jaxxtech/VectorNetworkAnalyser/README.md

View this project on [CADLAB.io](https://cadlab.io/project/1782). 

# VectorNetworkAnalyser
