jaxxtech/VectorNetworkAnalyser/VNA/vna/vna-partslist.xlsx

Id | Designator | Item | Quantity | Designation/value | rs stock no | unit cost | total | min qty | notes | ordering
1 | J9 | 15 pin 2.54mm pin header socket | 1 | vin_d13 |  |  | 0 |  |  | fset store
2 | J8 | 15 pin 2.54mm pin header socket | 1 | tx_d12 |  |  | 0 |  |  | fset store
3 | Y1 | QANTEK 16MHz Crystal ±20ppm HC-49/U-S 2-Pin, in pack of 10 | 1 | 16MHz | 814-9440 | 0.35 | 0.35 | 10 |  | rs components, or similar
4 | X1 | Clock Oscillator 5H14ET-30.000, 30 MHz, ±50ppm HCMOS, TTL 15pF, 14-Pin PDIP, 20.2 x 10.7 x 5.08mm | 1 | 30MHz | 767-5285 | 2.32 | 2.32 | 1 |  | rs components, or similar
5 | U9,U3,U2 | HMC284 RF Switch IC | 3 | HMC284 | 862-6310 | 4.195 | 12.585 | 2 |  | from rs components
6 | U8 | Microchip Technology ATMEGA328P-AU, 8bit AVR Microcontroller, 20MHz, 32 kB Flash, 32-Pin TQFP | 1 | ATmega328PB-AU | 131-0271 | 3.41 | 3.41 | 2 |  | fset store or rs components
7 | U7 | FTDI Chip FT232RL USB to Serial UART 3MBd, 28-Pin, SSOP | 1 | FT232RL | 406-580 | 8.03 | 8.03 | 1 |  | fset store or rs components
8 | U6 | Texas Instruments LM1117MP-5.0/NOPB, LDO Regulator, 800mA, 5 V, ±1% 3+Tab-Pin, SOT-223 | 1 | LM1117-5.0 | 533-9583 | 1.56 | 1.56 | 1 |  | from fset store
9 | U5 | AD8302ARUZ Analog Devices, RF Amplifier Gain and Phase Detector 2-Channel, 14-Pin TSSOP | 1 | AD8302ARUZ | 697-7262 | 34.86 | 34.86 | 1 |  | from rs components
10 | U4 | AD9851BRSZ, Direct Digital Synthesizer 10 bit-Bit 180000ksps, 28-Pin SSOP | 1 | AD9851 | 413-011 | 40.54 | 40.54 | 1 |  | from rs components
11 | U1 | NXP 74HCT04D,652, Hex Inverter, 4.5 ? 5.5 V, 14-Pin SOIC | 1 | 74HCT04 | 112-9988 | 0.51 | 0.51 | 1 |  | fset store or rs components
12 | SW1 | Surface mount SPDT push button Switch, normally open | 1 | Reset | 718-2477 | 0.4 | 0.4 | 5 |  | rs components or fset store
13 | R23,R20,R16,R15,R14,R13,R12,R11,R10,R9 | surface mount resistor | 10 | 1k |  |  |  |  |  | fset store
14 | R22 | surface mount resistor | 1 | 3.9k |  |  |  |  |  | fset store
15 | R21 | surface mount resistor | 1 | 25 |  |  |  |  |  | fset store
16 | R19,R18,R6,R5,R4,R3,R2,R1 | surface mount resistor | 8 | 50 |  |  |  |  |  | fset store
17 | R17 | surface mount resistor | 1 | 2k |  |  |  |  |  | fset store
18 | R8,R7 | surface mount resistor | 2 | 47 |  |  |  |  |  | fset store
19 | J7 | 6 pin 2.54mm pin header socket | 1 | Bluetooth Module Socket | 267-7400 | 1.022 | 1.022 | 5 | comes in runs of 20 pins | fset store
20 | J6 | 3 PinHeader_1x03_P2.54mm_Vertical | 1 | ICSP 2,4,6 | 547-3166 | 1.41 | 1.41 | 1 | run of 36 pins | fset store
21 | J5 | 3 PinHeader_1x03_P2.54mm_Vertical | 1 | ICSP 1,3,5 |  |  | 0 |  |  | fset store
22 | J4 | TE Connectivity Right Angle 50? PCB Mount BNC Connector, jack, Nickel, Through Hole Termination | 1 | Pt2 | 616-3090 | 3.75 | 3.75 | 1 |  | rs components
23 | J3 | TE Connectivity Right Angle 50? PCB Mount BNC Connector, jack, Nickel, Through Hole Termination | 1 | Pt1 | 616-3090 | 3.75 | 3.75 | 1 |  | rs components
24 | J2 | DC barrel jack, pcb mount | 1 | DC_IN_Conn | 122-4879 | 1.75 | 1.75 | 5 |  | rs components
25 | J1 | Amphenol FCI, Right Angle SMT, Type B Version 2.0 Micro USB Connector Receptacle | 1 | USB_B_Micro | 714-2347 | 1.05 | 1.05 | 5 |  | rs components
26 | HY2,HY1 | Directional_Coupler | 2 | Directional_Coupler | n/a | 0 | 0 | 0 | hand built | n/a
27 | D5 | SMD Chip LED - red | 1 | TX_LED |  |  | 0 |  |  | fset store
28 | D4 | SMD Chip LED - blue | 1 | onboard led |  |  | 0 |  |  | fset store
29 | D3 | SMD Chip LED - green | 1 | RX_LED |  |  | 0 |  |  | fset store
30 | D2 | SMD Chip LED - red | 1 | POWER_LED |  |  | 0 |  |  | fset store
31 | D1 | 40V schottky 350mA, Diode, 2-Pin SOD-323 | 1 | S4 |  |  | 0 |  |  | fset store or rs components
32 | C35,C34,C33,C32,C30 | Surface mount Capacitor | 5 | 0.1u |  |  | 0 |  |  | fset store
33 | C31 | Surface mount Capacitor | 1 | 10u |  |  | 0 |  |  | fset store
34 | C29 | Surface mount Capacitor | 1 | 330p |  |  | 0 |  |  | fset store
35 | C28 | Surface mount Capacitor | 1 | 330u |  |  | 0 |  |  | fset store
36 | C27,C26 | Surface mount Capacitor - timing circuit must be C0G | 2 | C0G 22p |  |  | 0 |  |  | fset store
37 | C25,C24,C23,C22,C21,C17,C6,C5,C4,C3,C2,C1 | Surface mount Capacitor | 12 | 100n |  |  | 0 |  |  | fset store
38 | C20,C18,C15 | Surface mount Capacitor | 3 | 1u |  |  | 0 |  |  | fset store
39 | C19,C16 | Surface mount Capacitor | 2 | 4.7u |  |  | 0 |  |  | fset store
40 | C14,C12 |  | 2 | DNP |  |  | 0 |  |  | n/a
41 | C13,C11,C10,C9,C8,C7 | Surface mount Capacitor | 6 | 1n |  |  | 0 |  |  | fset store
 |  |  |  |  |  | total cost | 117.297
