jaxxtech/VectorNetworkAnalyser/VNA/vna/vna.kicad_pcb

## KiCad design VNA/vna/vna.kicad_pcb (2019-10-09)

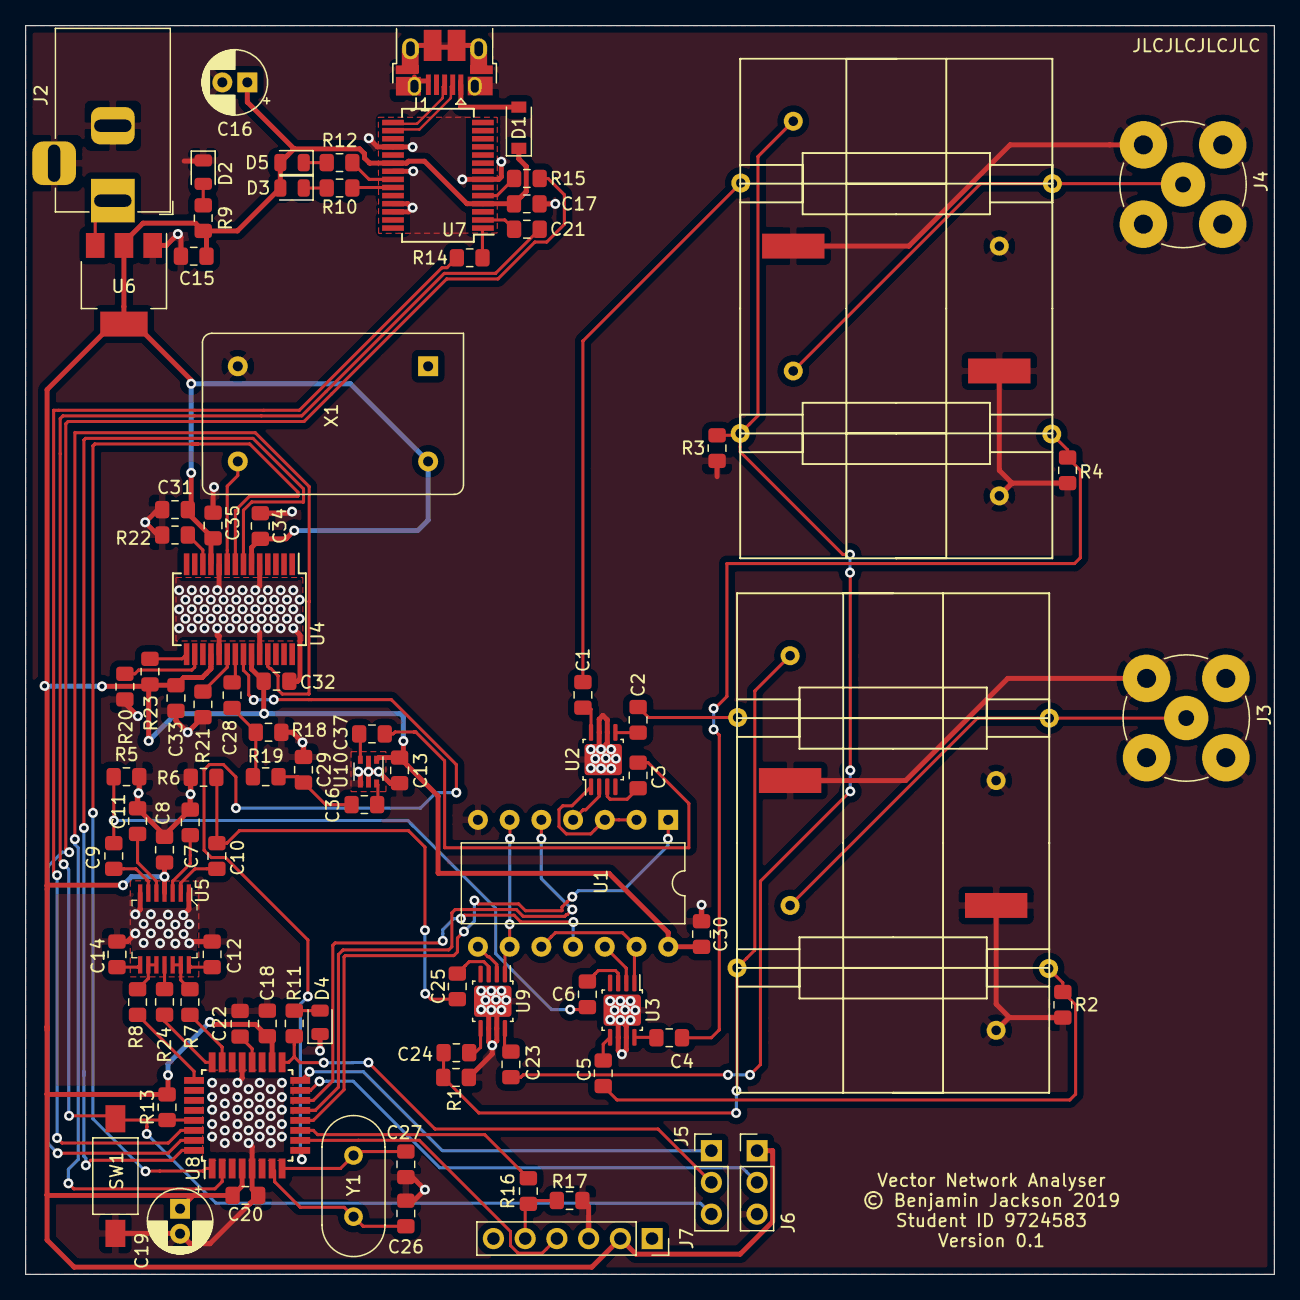
[picture p1: board vna.kicad_pcb from above]

Board: 2 copper layers, 100.0 x 100.0 mm, 88 parts (0 on the bottom side), 82 nets.

Parts:
C1, C2, C3, C4, C5, C6, C17, C21, C22, C23, C24, C25, C28: 100n; C_0805_2012Metric_Pad1.15x1.40mm_HandSolder
C7, C8, C9, C10, C11, C29: 1n; C_0805_2012Metric_Pad1.15x1.40mm_HandSolder
C12, C14: DNP; C_0805_2012Metric_Pad1.15x1.40mm_HandSolder
C13, C36, C37: 470p; C_0805_2012Metric_Pad1.15x1.40mm_HandSolder
C15, C18, C20: 1u; C_0805_2012Metric_Pad1.15x1.40mm_HandSolder
C16, C19: 4.7u; CP_Radial_D5.0mm_P2.00mm
C26, C27: C0G 22p; C_0805_2012Metric_Pad1.15x1.40mm_HandSolder
C30, C32, C33, C34, C35: 0.1u; C_0805_2012Metric_Pad1.15x1.40mm_HandSolder
C31: 10u; C_0805_2012Metric_Pad1.15x1.40mm_HandSolder
D1: S4; D_SOD-123
D2: POWER_LED; LED_0805_2012Metric
D3: RX_LED; LED_0805_2012Metric
D4: onboard led; LED_0805_2012Metric
D5: TX_LED; LED_0805_2012Metric
HY1, HY2: Directional_Coupler
J1: USB_B_Micro; USB_Micro-B_Amphenol_10103594-0001LF_Horizontal
J2: DC_IN_Conn; BarrelJack_Horizontal
J3: Pt1; BNC_TEConnectivity_1478204_Vertical
J4: Pt2; BNC_TEConnectivity_1478204_Vertical
J5: ICSP 1,3,5; PinHeader_1x03_P2.54mm_Vertical
J6: ICSP 2,4,6; PinHeader_1x03_P2.54mm_Vertical
J7: Bluetooth Module Socket; PinSocket_1x06_P2.54mm_Vertical
R1, R2: 50 DNP; R_0805_2012Metric_Pad1.15x1.40mm_HandSolder
R3, R4: 50_DNP; R_0805_2012Metric_Pad1.15x1.40mm_HandSolder
R5, R6: 50; R_0805_2012Metric_Pad1.15x1.40mm_HandSolder
R7, R8, R24: 47; R_0805_2012Metric_Pad1.15x1.40mm_HandSolder
R9, R10, R11, R12, R13, R14, R15, R16, R20, R23: 1k; R_0805_2012Metric_Pad1.15x1.40mm_HandSolder
R17: 2k; R_0805_2012Metric_Pad1.15x1.40mm_HandSolder
R18: 16k; R_0805_2012Metric_Pad1.15x1.40mm_HandSolder
R19: 100m; R_0805_2012Metric_Pad1.15x1.40mm_HandSolder
R21: 25; R_0805_2012Metric_Pad1.15x1.40mm_HandSolder
R22: 3.9k; R_0805_2012Metric_Pad1.15x1.40mm_HandSolder
SW1: Reset; SW_SPST_FSMSM
U1: 74HCT04; DIP-14_W10.16mm
U2, U3, U9: HMC284; MSOP-8-1EP_3x3mm_P0.65mm_EP2.5x3mm_Mask1.73x2.36mm
U4: AD9851; SSOP-28_5.3x10.2mm_P0.65mm
U5: AD8302ARUZ; TSSOP-14_W4.4mm
U6: LM1117-5.0; SOT-223-3_TabPin2
U7: FT232RL; SSOP-28_5.3x10.2mm_P0.65mm
U8: ATmega328PB-AU; TQFP-32_7x7mm_P0.8mm
U10: BGA2851; SOT-363_SC-70-6
X1: 30MHz; Oscillator_DIP-14
Y1: 16MHz; Crystal_HC18-U_Vertical

Connections:
+5V: C8.2, C13.1, C15.1, C16.1, C17.1, C18.1, C19.1, C20.1, C30.1, C31.1, C32.1, C33.1, C34.1, C35.1, D1.1, D3.2, D5.2, J6.1, J7.2, R9.1, R13.1, R23.2, U1.14, U4.6, U4.11, U4.18, U4.23, U5.4, U6.2, U7.4, U7.20, U8.4, U8.18, U10.1, X1.14
/ACtrl: U1.5, U8.13
/Aref: C22.1, U8.20
/BCtrl: U1.11, U8.14
/ControlSystem.sch/AIN1_D7: R16.2, U8.11
/ControlSystem.sch/OC0A_AIN0_D6: J7.4, U8.10
/ControlSystem.sch/OC3A_RXD_D0: R14.2, U8.30
/ControlSystem.sch/OC4A_TXD_D1: R15.1, U8.31
/ControlSystem.sch/RESET: C21.1, J5.3, R13.2, SW1.1, U8.29
/ControlSystem.sch/RX: R14.1, U7.1
/ControlSystem.sch/RXD1_MISO_D12: J5.1, U8.16
/ControlSystem.sch/SCK_D13: J5.2, R11.1, U8.17
/ControlSystem.sch/TX: R15.2, U7.5
/ControlSystem.sch/TXD1_MOSI_OC2_D11: J6.2, U8.15
/D+: J1.3, U7.15
/D-: J1.2, U7.16
/DATA: U4.25, U8.2
/FQ_UD: U4.8, U8.1
/Fmeasured: C6.2, C9.2, R5.2
/Freference: C10.2, C25.2, R6.1
/Fwd_50ohm_A: C24.1, HY1.4, HY1.7, R1.1
/Fwd_50ohm_B: C23.1, HY2.4, HY2.7, R3.1
/PowerManagement/USB5V: D1.2, J1.1
/RF_RESET: U4.22, U8.9
/Receiver.sch/OffsetA: C7.1, U5.3
/Receiver.sch/VMag: R7.1, U8.23
/Receiver.sch/VPhase: R8.1, U8.25
/Receiver.sch/VRef(1v7): R24.1, U8.24
/Rev_50ohm_A: C5.1, HY1.6, R2.1
/Rev_50ohm_B: C4.1, HY2.6, R4.1
/SRC_50ohm: C3.2, C37.1
/SrcCtrl: U1.1, U8.12
/Src_50ohm_A: C2.1, HY1.1
/Src_50ohm_B: C1.1, HY2.1
/W_CLK: U4.7, U8.32
/pt1_50ohm: HY1.2, HY1.10, J3.1
/pt2_50ohm: HY2.2, HY2.10, J4.1
GND: C7.2, C8.1, C11.1, C12.1, C13.2, C14.2, C15.2, C16.2, C17.2, C18.2, C19.2, C20.2, C22.2, C26.1, C27.1, C29.2, C30.2, C31.2, C32.2, C33.2, C34.2, C35.2, D2.1, D4.1, HY1.3, HY1.5, HY1.8, HY1.9, HY2.3, HY2.5, HY2.8, HY2.9, J1.5, J1.6, J2.2, J2.3, J3.2, J4.2, J6.3, J7.3, R1.2, R2.2, R3.2, R4.2, R5.1, R6.2, R17.1, R18.2, R20.1, R21.1, R22.1, SW1.2, U1.7, U2.6, U2.7, U2.9, U3.6, U3.7, U3.9, U4.5, U4.10, U4.19, U4.24, U5.1, U5.7, U6.1, U7.7, U7.18, U7.21, U7.25, U7.26, U8.5, U8.21, U9.6, U9.7, U9.9, U10.2, U10.4, U10.5, X1.7
unnamed: C1.2, U2.8
unnamed: C2.2, U2.5
unnamed: C3.1, U2.3
unnamed: C4.2, U3.8
unnamed: C5.2, U3.5
unnamed: C6.1, U3.3
unnamed: C9.1, U5.6
unnamed: C10.1, U5.2
unnamed: C11.2, U5.5
unnamed: C12.2, U5.14
unnamed: C14.1, U5.8
unnamed: C21.2, U7.2
unnamed: C23.2, U9.8
unnamed: C24.2, U9.5
unnamed: C25.1, U9.3
unnamed: C26.2, U8.7, Y1.1
unnamed: C27.2, U8.8, Y1.2
unnamed: C28.1, R18.1, R19.1
unnamed: C28.2, U4.21
unnamed: C29.1, C36.2, R19.2
unnamed: C36.1, U10.6
unnamed: C37.2, U10.3
unnamed: D2.2, R9.2
unnamed: D3.1, R10.1
unnamed: D4.2, R11.2
unnamed: D5.1, R12.1
unnamed: J7.5, R16.1, R17.2
unnamed: R7.2, U5.12, U5.13
unnamed: R8.2, U5.9, U5.10
unnamed: R10.2, U7.23
unnamed: R12.2, U7.22
unnamed: R20.2, U4.16
unnamed: R21.2, U4.20
unnamed: R22.2, U4.12
unnamed: R23.1, U4.15
unnamed: R24.2, U5.11
unnamed: U1.2, U1.3, U2.1
unnamed: U1.4, U2.2
unnamed: U1.6, U1.9, U9.1
unnamed: U1.8, U9.2
unnamed: U1.10, U1.13, U3.1
unnamed: U1.12, U3.2
unnamed: U4.9, X1.8
VDC: J2.1, U6.3
