jaxxtech/VectorNetworkAnalyser/(commit log)

2019-05-17 initial commit
    initial commit in order to test cadlab.io
    [ControlSystem.sch, Directional-Coupler.sch, DirectionalCoupler1.sch, DirectionalCoupler2.sch, RFSwitchFWD.sch, RFSwitchREV.sch, RFSwitchSource.sch, Receiver.sch]
2019-05-17 power and rf src blocks added
    battery managemet and rf source heirachical schematics have been added.
    these schematics are still empty however will server as a test for visual diff.
    [BatteryManagement.sch, ControlSystem.sch, DirectionalCoupler1.sch, DirectionalCoupler2.sch, RFSource.sch, RFSwitchFWD.sch, RFSwitchREV.sch, RFSwitchSource.sch]
2019-05-17 main block editing
    main block schematic moved around to allow for better routing.
    power connectors and usb yet to be placed
    bluetooth module also not yet implemented
    [vna.sch]
2019-05-21 block diagram for presentation completed
    at this stage i have completed the overall block diagram for the initial presentation.
    the blocks are mostly empty and require further development. the overall block diagram neglects power supply connections for clarity, these will be added internal to the blocks.
    [BatteryManagement.sch, ControlSystem.sch, DirectionalCoupler1.sch, DirectionalCoupler2.sch, RFSource.sch, RFSwitchFWD.sch, RFSwitchREV.sch, RFSwitchSource.sch]
2019-05-23 adjusted main schematic to suit initial presentation
    i moved a few blocks around so that the cropped version of the block diagram would fit nicely in my semester 1 presentation
    [ControlSystem.sch, DirectionalCoupler1.sch, DirectionalCoupler2.sch, RFSource.sch, RFSwitchFWD.sch, RFSwitchREV.sch, RFSwitchSource.sch, Receiver.sch]
2019-06-01 changed inductors to a single transformer component
    inductors in the directional couplers was changed to a single transformer
    this will help with later layout opperations
    [DirectionalCoupler1.sch, DirectionalCoupler2.sch, vna.sch]
2019-08-22 micro-controller pins labelled
    micro controller pins have been labelled, the pins on the bottom are yet to be linked to them.
    still to wire up ftdi chip,
    still to decide upon rf switch control schema.
    [ControlSystem.sch, DirectionalCoupler1.sch, DirectionalCoupler2.sch, RFSwitchFWD.sch, RFSwitchREV.sch, RFSwitchSource.sch, Receiver.sch, vna.sch]
2019-09-19 finished controller, chose compatible switches
    controller and rf switches have been completed.
    ToDo: finish filter design for RF Source, add auto gain control
    ToDo: finish directional coupler footprints
    ToDo: PCB Layout
    [BatteryManagement.sch, ControlSystem.sch, DirectionalCoupler1.sch, DirectionalCoupler2.sch, PowerManagement.sch, RFSource.sch, RFSwitchFWD.sch, RFSwitchREV.sch]
2019-09-20 custom footprint for couplers, added decoupling caps
    added custom footprint for directional couplers - will need to verify it
    added decoupling caps to ad9851
    [ControlSystem.sch, DirectionalCoupler1.sch, DirectionalCoupler2.sch, PowerManagement.sch, RFSource.sch, RFSwitchFWD.sch, RFSwitchREV.sch, RFSwitchSource.sch]
2019-09-22 beginning pcb layout
    pcb layout process begun
    [ControlSystem.sch, RFSource.sch, vna.kicad_pcb, vna.sch]
2019-09-29 initial pcb design
    initial layout and grouping of components complete
    [ControlSystem.sch, DirectionalCoupler1.sch, DirectionalCoupler2.sch, PowerManagement.sch, RFSource.sch, RFSwitchFWD.sch, RFSwitchREV.sch, RFSwitchSource.sch]
2019-10-09 v0.1 completed, producing gerbers
    gerbers to be sent to jlc pcb pending their acceptance, they will be produced
    [ControlSystem.sch, DirectionalCoupler1.sch, DirectionalCoupler2.sch, RFSource.sch, RFSwitchFWD.sch, RFSwitchREV.sch, RFSwitchSource.sch, _saved_vna.sch]
2019-10-09 saved pcb file
    [vna.kicad_pcb]
