jaxxtech/VectorNetworkAnalyser/(notices)

Notices in the files:
VNA/vna/vna.kicad_pcb:
© Benjamin Jackson 2019
